ThomasJagielski/MADVLSI-Final_Project/docs/adc.png

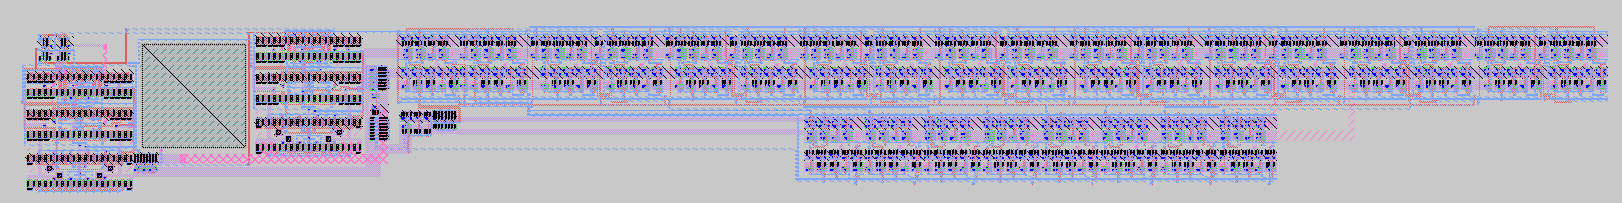
docs/adc.png
