ThomasJagielski/MADVLSI-Final_Project/docs/bandgap_ping_pong.png

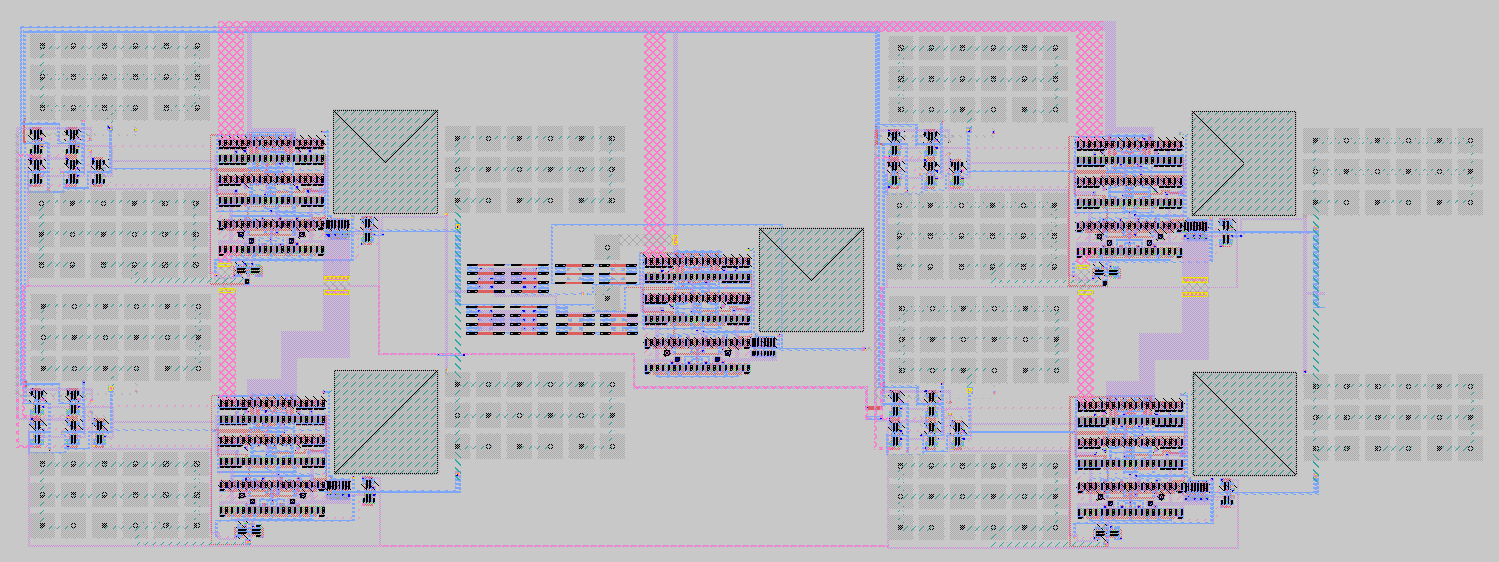
docs/bandgap_ping_pong.png
