ThomasJagielski/MADVLSI-Final_Project/docs/cap8to1.png

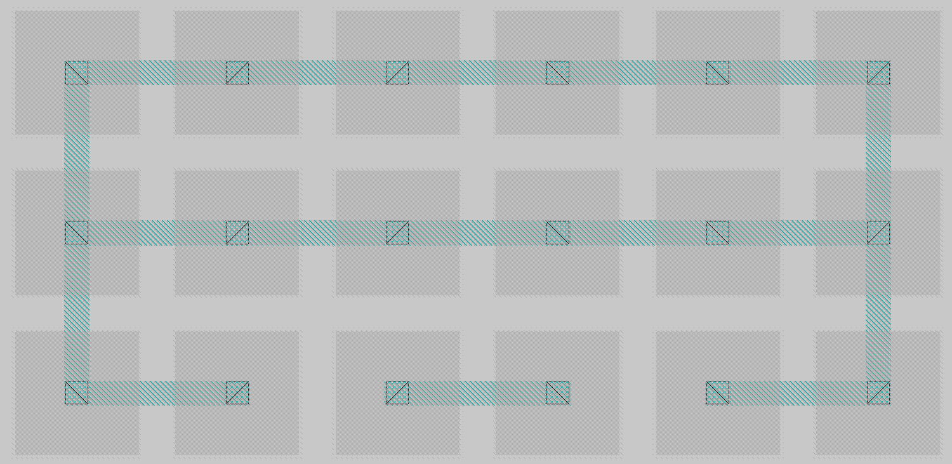
docs/cap8to1.png
