ThomasJagielski/MADVLSI-Final_Project/docs/comparator.png

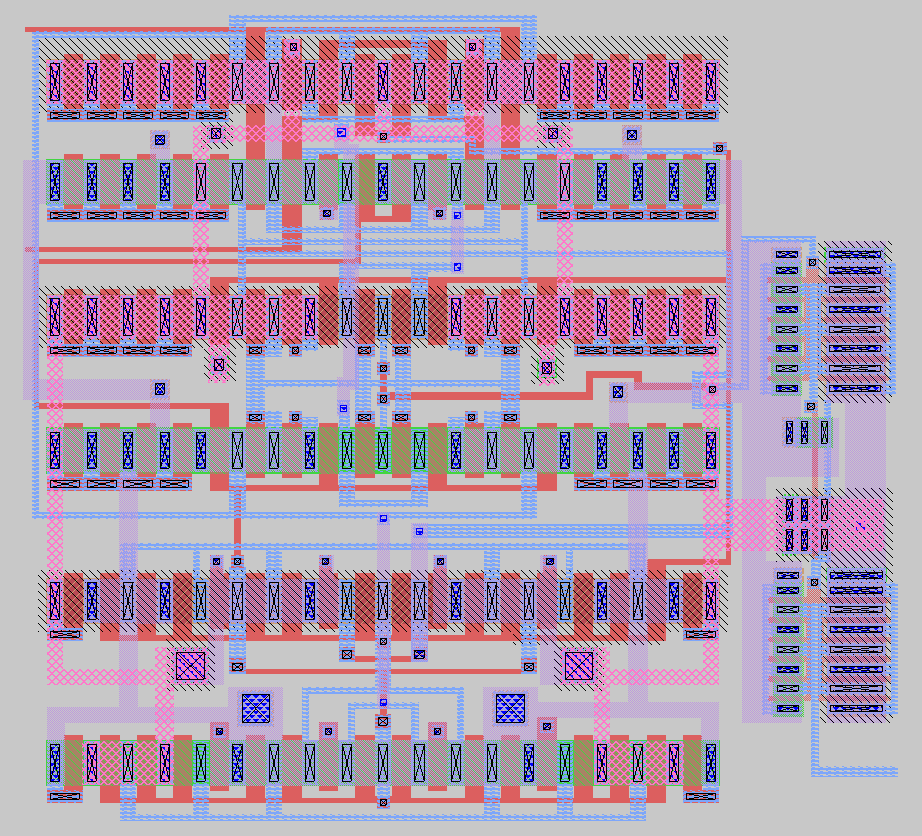
docs/comparator.png
