ThomasJagielski/MADVLSI-Final_Project/docs/middle_ping_pong_amplifier.png

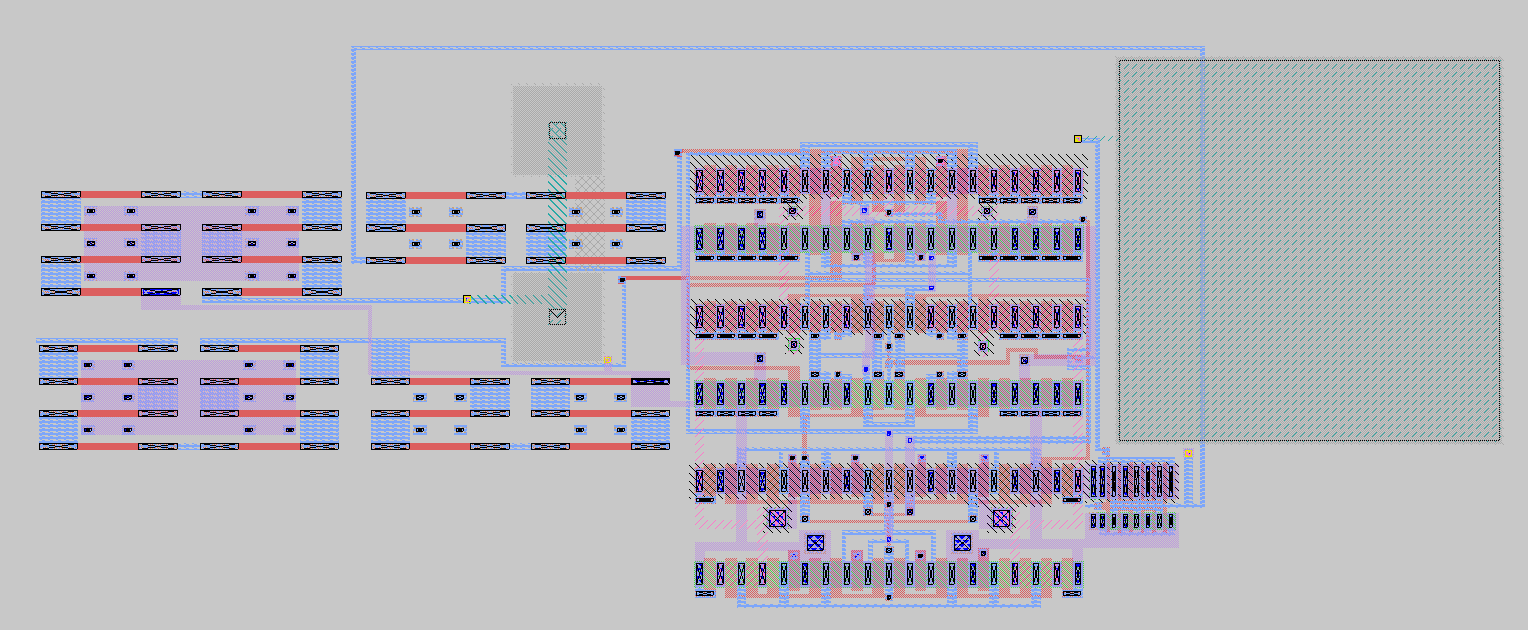
docs/middle_ping_pong_amplifier.png
