ThomasJagielski/MADVLSI-Final_Project/docs/output_register.png

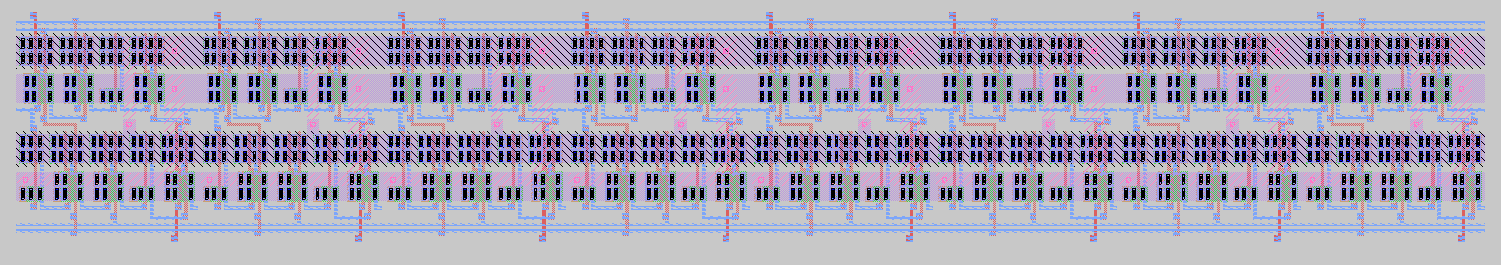
docs/output_register.png
