ThomasJagielski/MADVLSI-Final_Project/synthesized/counter/magic/counter.gds.png

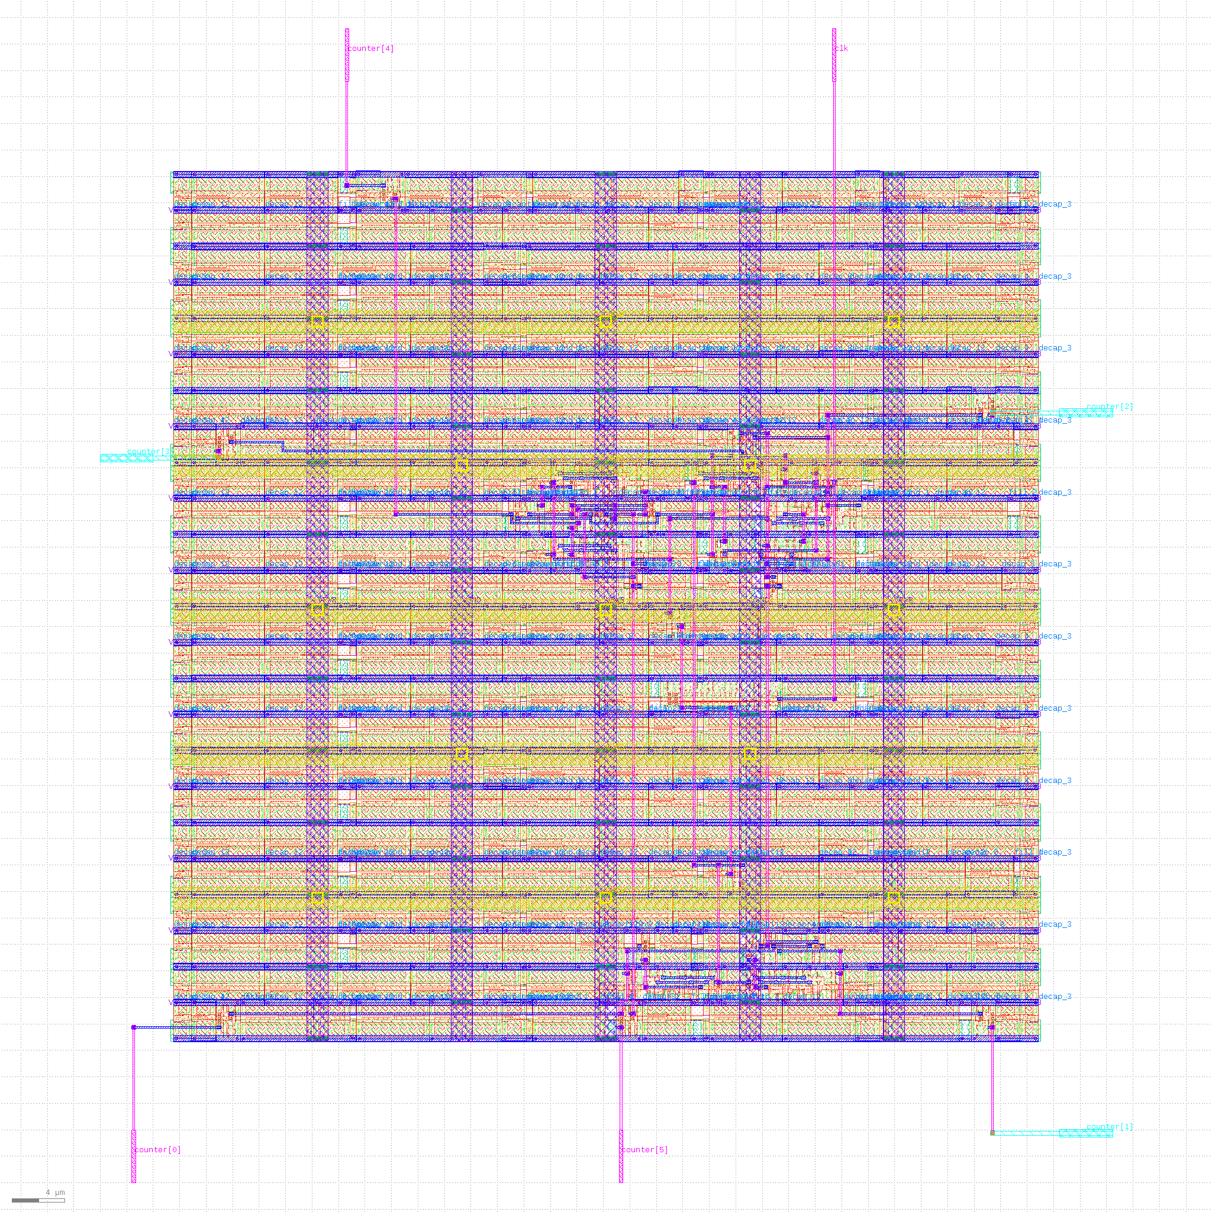
synthesized/counter/magic/counter.gds.png
