ThomasJagielski/MADVLSI-Final_Project/schematic/data/Vtemp_test-20-100Cndiode.csv

 vbep            v(Vbep)         vbep            v(vben)         yes             currtemp
 9.74964207e-01  9.74964207e-01  9.74964207e-01  9.24703032e-01  1.00000000e+00 -2.00000000e+01
 9.74206963e-01  9.74206963e-01  9.74206963e-01  9.23756736e-01  1.00000000e+00 -1.90000000e+01
 9.73447955e-01  9.73447955e-01  9.73447955e-01  9.22808677e-01  1.00000000e+00 -1.80000000e+01
 9.72687192e-01  9.72687192e-01  9.72687192e-01  9.21858862e-01  1.00000000e+00 -1.70000000e+01
 9.71924679e-01  9.71924679e-01  9.71924679e-01  9.20907299e-01  1.00000000e+00 -1.60000000e+01
 9.71160423e-01  9.71160423e-01  9.71160423e-01  9.19953993e-01  1.00000000e+00 -1.50000000e+01
 9.70394432e-01  9.70394432e-01  9.70394432e-01  9.18998952e-01  1.00000000e+00 -1.40000000e+01
 9.69626712e-01  9.69626712e-01  9.69626712e-01  9.18042182e-01  1.00000000e+00 -1.30000000e+01
 9.68857269e-01  9.68857269e-01  9.68857269e-01  9.17083690e-01  1.00000000e+00 -1.20000000e+01
 9.68086110e-01  9.68086110e-01  9.68086110e-01  9.16123482e-01  1.00000000e+00 -1.10000000e+01
 9.67313242e-01  9.67313242e-01  9.67313242e-01  9.15161566e-01  1.00000000e+00 -1.00000000e+01
 9.66538671e-01  9.66538671e-01  9.66538671e-01  9.14197947e-01  1.00000000e+00 -9.00000000e+00
 9.65762404e-01  9.65762404e-01  9.65762404e-01  9.13232633e-01  1.00000000e+00 -8.00000000e+00
 9.64984446e-01  9.64984446e-01  9.64984446e-01  9.12265628e-01  1.00000000e+00 -7.00000000e+00
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
 8.74954367e-01  8.74954367e-01  8.74954367e-01  8.02383361e-01  1.00000000e+00  9.80000000e+01
 8.74025949e-01  8.74025949e-01  8.74025949e-01  8.01265880e-01  1.00000000e+00  9.90000000e+01
 8.73096327e-01  8.73096327e-01  8.73096327e-01  8.00147194e-01  1.00000000e+00  1.00000000e+02
