ThomasJagielski/MADVLSI-Final_Project/synthesized/decimation_filter/results/cts/decimation_filter.cts.def.png

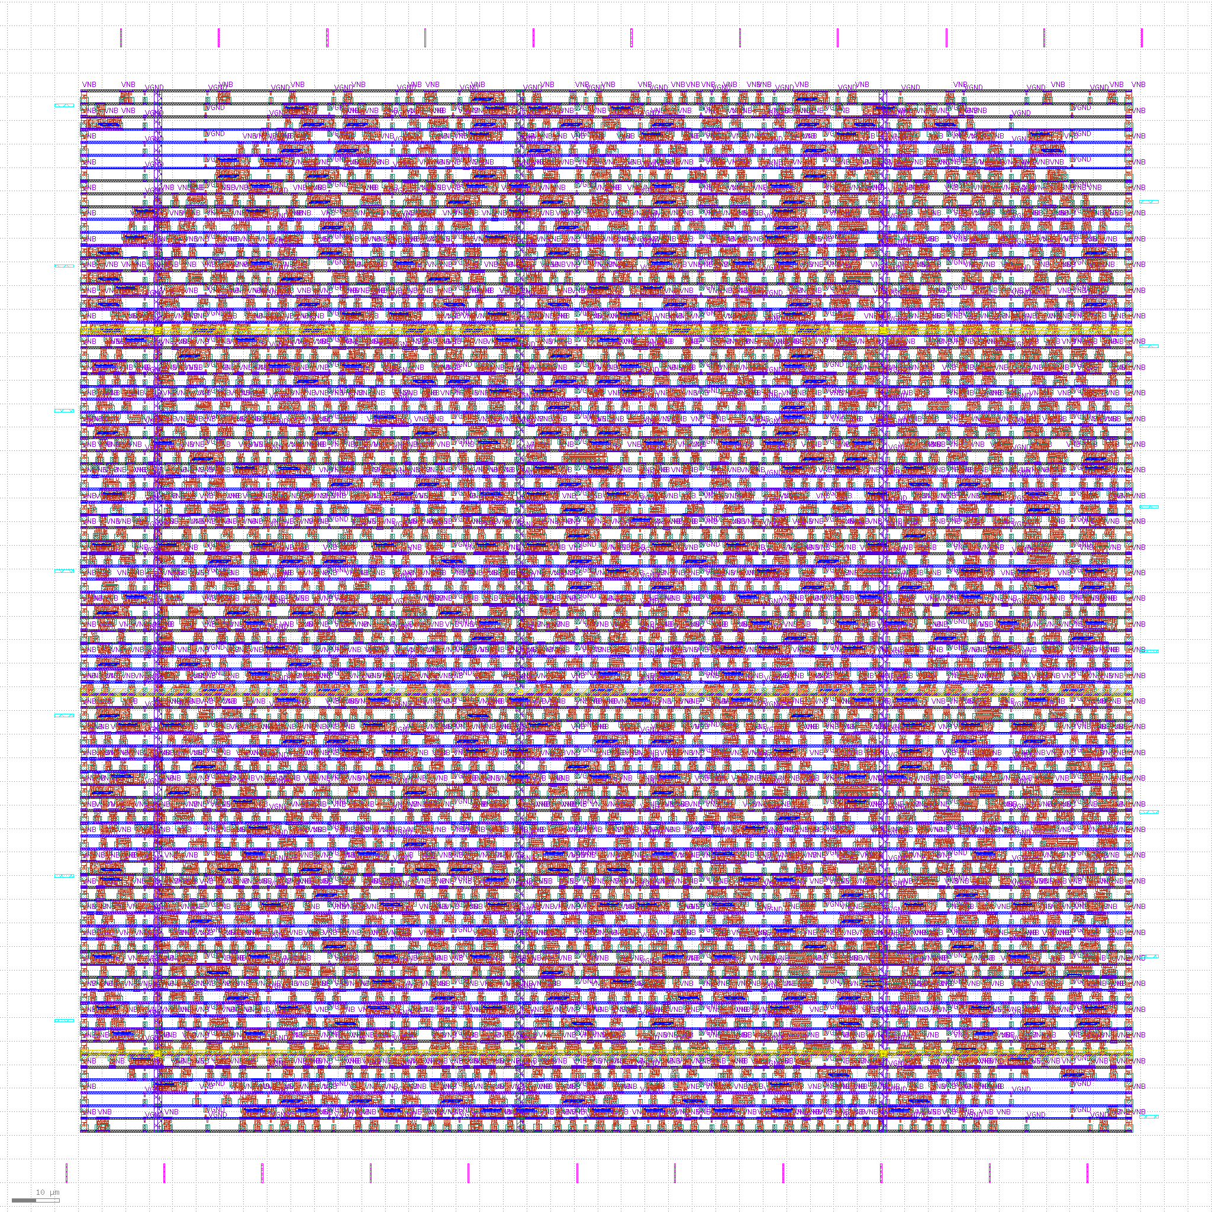
synthesized/decimation_filter/results/cts/decimation_filter.cts.def.png
