ThomasJagielski/MADVLSI-Final_Project/synthesized/decimation_filter/results/floorplan/decimation_filter.floorplan.def.png

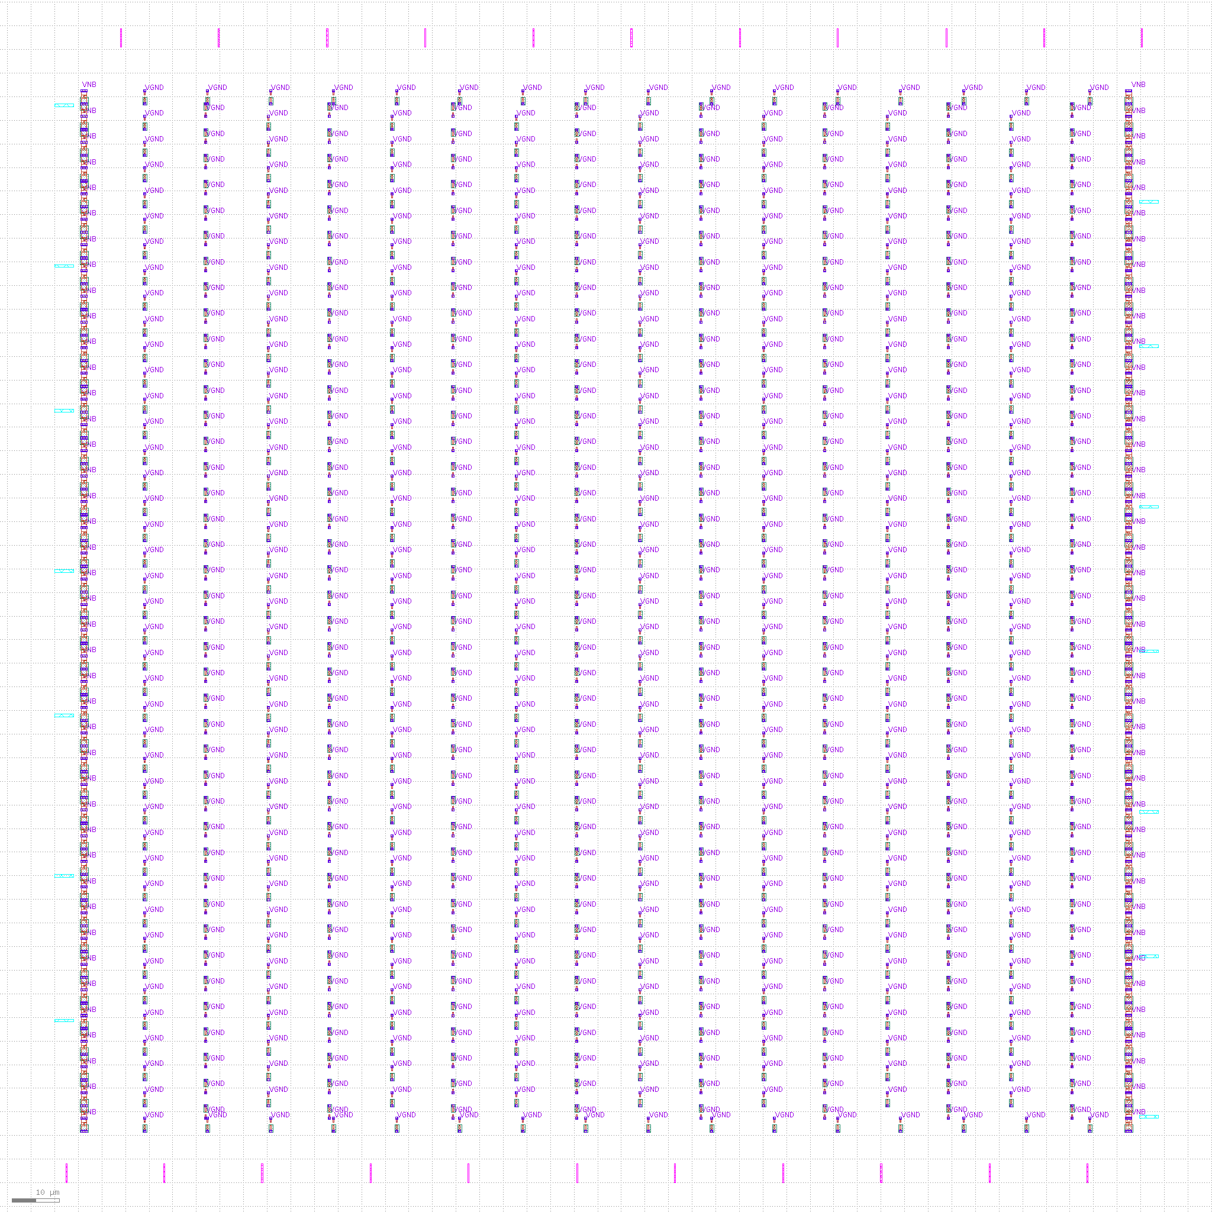
synthesized/decimation_filter/results/floorplan/decimation_filter.floorplan.def.png
