ThomasJagielski/MADVLSI-Final_Project/synthesized/decimation_filter/results/magic/decimation_filter.gds.png

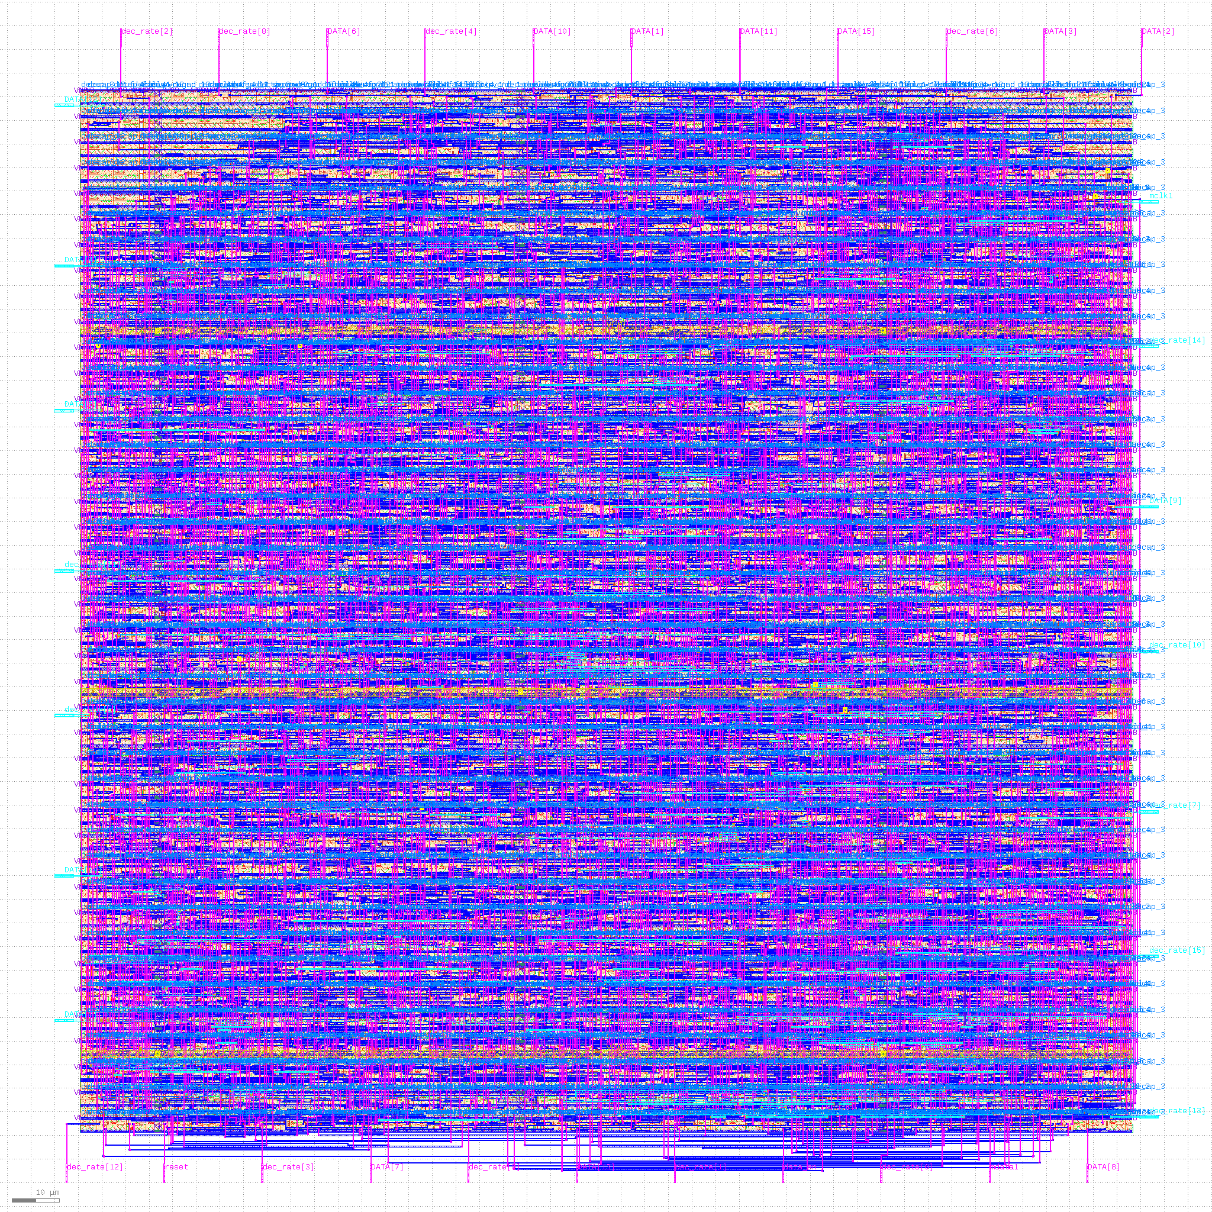
synthesized/decimation_filter/results/magic/decimation_filter.gds.png
