ThomasJagielski/MADVLSI-Final_Project/synthesized/decimation_filter/results/routing/decimation_filter.def.png

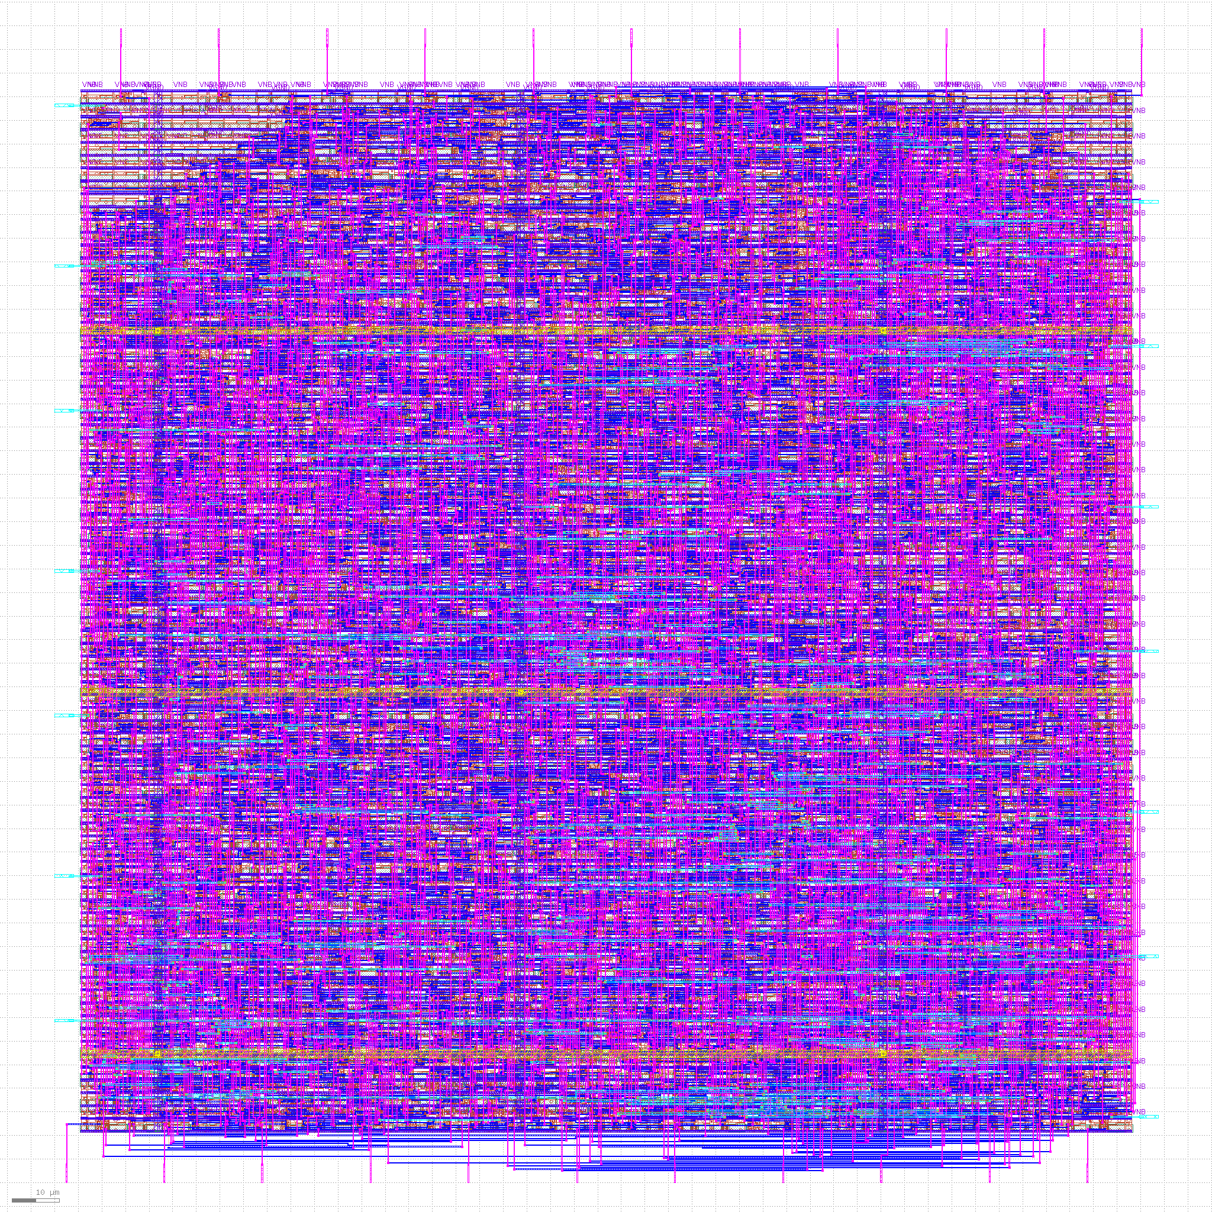
synthesized/decimation_filter/results/routing/decimation_filter.def.png
