ThomasJagielski/MADVLSI-Final_Project/lvs/temperature_sensor/test/temp_sense_test_lvs.spice

**.subckt temp_sense_test_lvs
X38 VDD Vflag GND net15 adc_CLK and2
X39 Q0 __UNCONNECTED_PIN__0 Qout0 Vflag P C dff
X40 Q1 __UNCONNECTED_PIN__1 Qout1 Vflag P C dff
X47 Q2 __UNCONNECTED_PIN__2 Qout2 Vflag P C dff
X48 Q3 __UNCONNECTED_PIN__3 Qout3 Vflag P C dff
X49 Q4 __UNCONNECTED_PIN__4 Qout4 Vflag P C dff
X50 Q5 __UNCONNECTED_PIN__5 Qout5 Vflag P C dff
X51 Q6 __UNCONNECTED_PIN__6 Qout6 Vflag P C dff
X52 Q7 __UNCONNECTED_PIN__7 Qout7 Vflag P C dff
X43 Qn0 __UNCONNECTED_PIN__8 net4 net3 P C dff
X44 net4 Qn0 __UNCONNECTED_PIN__9 net5 C P dff
X45 net3 net5 VDD GND inverter
X46 Qn1 __UNCONNECTED_PIN__10 net6 net17 P C dff
X53 net6 Qn1 __UNCONNECTED_PIN__11 Q0 C P dff
X54 Q0 net17 VDD GND inverter
X55 Qn2 __UNCONNECTED_PIN__12 net7 net18 P C dff
X56 net7 Qn2 __UNCONNECTED_PIN__13 Q1 C P dff
X57 Qn3 __UNCONNECTED_PIN__14 net8 net19 P C dff
X58 net8 Qn3 __UNCONNECTED_PIN__15 Q2 C P dff
X61 Q1 net18 VDD GND inverter
X62 Q2 net19 VDD GND inverter
X64 net4 Q0 VDD GND inverter
X65 net6 Q1 VDD GND inverter
X66 net7 Q2 VDD GND inverter
X67 net8 Q3 VDD GND inverter
X41 Qn4 __UNCONNECTED_PIN__16 net9 net20 P C dff
X42 net9 Qn4 __UNCONNECTED_PIN__17 Q3 C P dff
X59 Q3 net20 VDD GND inverter
X60 net9 Q4 VDD GND inverter
X63 Qn5 __UNCONNECTED_PIN__18 net10 net21 P C dff
X68 net10 Qn5 __UNCONNECTED_PIN__19 Q4 C P dff
X69 Q4 net21 VDD GND inverter
X70 Qn6 __UNCONNECTED_PIN__20 net11 net22 P C dff
X71 net11 Qn6 __UNCONNECTED_PIN__21 Q5 C P dff
X72 Qn7 __UNCONNECTED_PIN__22 net12 net23 P C dff
X73 net12 Qn7 __UNCONNECTED_PIN__23 Q6 C P dff
X74 Q5 net22 VDD GND inverter
X75 Q6 net23 VDD GND inverter
X76 net10 Q5 VDD GND inverter
X77 net11 Q6 VDD GND inverter
X78 net12 Q7 VDD GND inverter
X79 Qn8 __UNCONNECTED_PIN__24 net13 net24 P C dff
X80 net13 Qn8 __UNCONNECTED_PIN__25 Q7 C P dff
X81 Q7 net24 VDD GND inverter
X82 net13 Q8 VDD GND inverter
X83 net1 net2 NP P switch Wp=1 Lp=0.15 WW=1 LL=0.15
X84 Vref_adc net1 NP P switch Wp=1 Lp=0.15 WW=1 LL=0.15
X85 Vref_adc net2 net1 selfbiasedcascode2stage_lvs
X86 Vref_adc net1 Vflag comparator_lvs
XM25 net14 net15 VDD VDD sky130_fd_pr__pfet_01v8 L=0.15 W=2 nf=1 ad='int((nf+1)/2) * W/nf * 0.29' as='int((nf+2)/2) * W/nf * 0.29'
+ pd='2*int((nf+1)/2) * (W/nf + 0.29)' ps='2*int((nf+2)/2) * (W/nf + 0.29)' nrd='0.29 / W' nrs='0.29 / W'
+ sa=0 sb=0 sd=0 mult=1 m=1 
XM26 net14 net15 GND GND sky130_fd_pr__nfet_01v8 L=0.15 W=1 nf=1 ad='int((nf+1)/2) * W/nf * 0.29' as='int((nf+2)/2) * W/nf * 0.29'
+ pd='2*int((nf+1)/2) * (W/nf + 0.29)' ps='2*int((nf+2)/2) * (W/nf + 0.29)' nrd='0.29 / W' nrs='0.29 / W'
+ sa=0 sb=0 sd=0 mult=1 m=1 
XM27 net3 net14 VDD VDD sky130_fd_pr__pfet_01v8 L=0.15 W=12 nf=1 ad='int((nf+1)/2) * W/nf * 0.29' as='int((nf+2)/2) * W/nf * 0.29'
+ pd='2*int((nf+1)/2) * (W/nf + 0.29)' ps='2*int((nf+2)/2) * (W/nf + 0.29)' nrd='0.29 / W' nrs='0.29 / W'
+ sa=0 sb=0 sd=0 mult=1 m=1 
XM28 net3 net14 GND GND sky130_fd_pr__nfet_01v8 L=0.15 W=6 nf=1 ad='int((nf+1)/2) * W/nf * 0.29' as='int((nf+2)/2) * W/nf * 0.29'
+ pd='2*int((nf+1)/2) * (W/nf + 0.29)' ps='2*int((nf+2)/2) * (W/nf + 0.29)' nrd='0.29 / W' nrs='0.29 / W'
+ sa=0 sb=0 sd=0 mult=1 m=1 
X87 __UNCONNECTED_PIN__26 net16 GND Q8 mux2
**.ends

* expanding   symbol:  /home/madvlsi/Documents/MADVLSI-Final_Project/schematic/and2.sym # of pins=5

.subckt and2  VP A VN Y B
*.iopin VP
*.iopin VN
*.ipin A
*.ipin B
*.opin Y
X1 A B net1 VP VN nand2
X2 net1 Y VP VN inverter
.ends


* expanding   symbol:  /home/madvlsi/Documents/MADVLSI-Final_Project/schematic/dff.sym # of pins=6

.subckt dff  D Qn Q CLK Preset Clear
*.ipin D
*.iopin CLK
*.opin Qn
*.opin Q
*.ipin Preset
*.ipin Clear
X6 D CLK net4 VDD GND nand2
X7 net1 CLK net2 VDD GND nand2
X8 Q net3 Qn VDD GND nand2
X9 net5 Qn Q VDD GND nand2
X10 D net1 VDD GND inverter
X1 VDD Preset GND net5 net4 and2
X2 VDD net2 GND net3 Clear and2
.ends


* expanding   symbol:  /home/madvlsi/Documents/MADVLSI-Final_Project/schematic/inverter.sym # of
*+ pins=4

.subckt inverter  A Y VP VN
*.ipin A
*.iopin VP
*.iopin VN
*.opin Y
XM1 Y A VP VP sky130_fd_pr__pfet_01v8 L=0.15 W=2 nf=1 ad='int((nf+1)/2) * W/nf * 0.29' as='int((nf+2)/2) * W/nf * 0.29'
+ pd='2*int((nf+1)/2) * (W/nf + 0.29)' ps='2*int((nf+2)/2) * (W/nf + 0.29)' nrd='0.29 / W' nrs='0.29 / W'
+ sa=0 sb=0 sd=0 mult=1 m=1 
XM2 Y A VN VN sky130_fd_pr__nfet_01v8 L=0.15 W=1 nf=1 ad='int((nf+1)/2) * W/nf * 0.29' as='int((nf+2)/2) * W/nf * 0.29'
+ pd='2*int((nf+1)/2) * (W/nf + 0.29)' ps='2*int((nf+2)/2) * (W/nf + 0.29)' nrd='0.29 / W' nrs='0.29 / W'
+ sa=0 sb=0 sd=0 mult=1 m=1 
.ends


* expanding   symbol:  /home/madvlsi/Documents/MADVLSI-Final_Project/schematic/switch.sym # of
*+ pins=4

.subckt switch  B A CLK nCLK   Wp=1 Lp=0.15 WW=1 LL=0.15
*.iopin B
*.iopin A
*.ipin CLK
*.ipin nCLK
*.ipin CLK
*.ipin CLK
*.ipin nCLK
*.ipin nCLK
XM1 A CLK B GND sky130_fd_pr__nfet_01v8 L='LL' W='WW' nf=1 ad='int((nf+1)/2) * W/nf * 0.29' as='int((nf+2)/2) * W/nf * 0.29'
+ pd='2*int((nf+1)/2) * (W/nf + 0.29)' ps='2*int((nf+2)/2) * (W/nf + 0.29)' nrd='0.29 / W' nrs='0.29 / W'
+ sa=0 sb=0 sd=0 mult=1 m=1 
XM2 A nCLK B VDD sky130_fd_pr__pfet_01v8 L='Lp' W='Wp' nf=1 ad='int((nf+1)/2) * W/nf * 0.29' as='int((nf+2)/2) * W/nf * 0.29'
+ pd='2*int((nf+1)/2) * (W/nf + 0.29)' ps='2*int((nf+2)/2) * (W/nf + 0.29)' nrd='0.29 / W' nrs='0.29 / W'
+ sa=0 sb=0 sd=0 mult=1 m=1 
XM3 B CLK B VDD sky130_fd_pr__pfet_01v8 L='Lp' W='Wp/2' nf=1 ad='int((nf+1)/2) * W/nf * 0.29' as='int((nf+2)/2) * W/nf * 0.29'
+ pd='2*int((nf+1)/2) * (W/nf + 0.29)' ps='2*int((nf+2)/2) * (W/nf + 0.29)' nrd='0.29 / W' nrs='0.29 / W'
+ sa=0 sb=0 sd=0 mult=1 m=1 
XM4 A CLK A VDD sky130_fd_pr__pfet_01v8 L='Lp' W='Wp/2' nf=1 ad='int((nf+1)/2) * W/nf * 0.29' as='int((nf+2)/2) * W/nf * 0.29'
+ pd='2*int((nf+1)/2) * (W/nf + 0.29)' ps='2*int((nf+2)/2) * (W/nf + 0.29)' nrd='0.29 / W' nrs='0.29 / W'
+ sa=0 sb=0 sd=0 mult=1 m=1 
XM5 B nCLK B GND sky130_fd_pr__nfet_01v8 L='LL' W='WW/2' nf=1 ad='int((nf+1)/2) * W/nf * 0.29' as='int((nf+2)/2) * W/nf * 0.29'
+ pd='2*int((nf+1)/2) * (W/nf + 0.29)' ps='2*int((nf+2)/2) * (W/nf + 0.29)' nrd='0.29 / W' nrs='0.29 / W'
+ sa=0 sb=0 sd=0 mult=1 m=1 
XM6 A nCLK A GND sky130_fd_pr__nfet_01v8 L='LL' W='WW/2' nf=1 ad='int((nf+1)/2) * W/nf * 0.29' as='int((nf+2)/2) * W/nf * 0.29'
+ pd='2*int((nf+1)/2) * (W/nf + 0.29)' ps='2*int((nf+2)/2) * (W/nf + 0.29)' nrd='0.29 / W' nrs='0.29 / W'
+ sa=0 sb=0 sd=0 mult=1 m=1 
.ends


* expanding   symbol:
*+  /home/madvlsi/Documents/MADVLSI-Final_Project/schematic/selfbiasedcascode2stage_lvs.sym # of pins=3

.subckt selfbiasedcascode2stage_lvs  vp vm vout
*.ipin vm
*.ipin vp
*.opin vout
XMdummy1 net4 VDD net5 VDD sky130_fd_pr__pfet_01v8 L=0.6 W=1.5 nf=1 ad='int((nf+1)/2) * W/nf * 0.29'
+ as='int((nf+2)/2) * W/nf * 0.29' pd='2*int((nf+1)/2) * (W/nf + 0.29)' ps='2*int((nf+2)/2) * (W/nf + 0.29)'
+ nrd='0.29 / W' nrs='0.29 / W' sa=0 sb=0 sd=0 mult=1 m=1 
XM16a net4 vp net5 VDD sky130_fd_pr__pfet_01v8 L=0.6 W=1.5 nf=1 ad='int((nf+1)/2) * W/nf * 0.29' as='int((nf+2)/2) * W/nf * 0.29'
+ pd='2*int((nf+1)/2) * (W/nf + 0.29)' ps='2*int((nf+2)/2) * (W/nf + 0.29)' nrd='0.29 / W' nrs='0.29 / W'
+ sa=0 sb=0 sd=0 mult=1 m=1 
XM14a VDD net6 net4 VDD sky130_fd_pr__pfet_01v8 L=0.6 W=1.5 nf=1 ad='int((nf+1)/2) * W/nf * 0.29' as='int((nf+2)/2) * W/nf * 0.29'
+ pd='2*int((nf+1)/2) * (W/nf + 0.29)' ps='2*int((nf+2)/2) * (W/nf + 0.29)' nrd='0.29 / W' nrs='0.29 / W'
+ sa=0 sb=0 sd=0 mult=1 m=1 
XM14b net4 net6 VDD VDD sky130_fd_pr__pfet_01v8 L=0.6 W=1.5 nf=1 ad='int((nf+1)/2) * W/nf * 0.29' as='int((nf+2)/2) * W/nf * 0.29'
+ pd='2*int((nf+1)/2) * (W/nf + 0.29)' ps='2*int((nf+2)/2) * (W/nf + 0.29)' nrd='0.29 / W' nrs='0.29 / W'
+ sa=0 sb=0 sd=0 mult=1 m=1 
XM15a net4 vm net8 VDD sky130_fd_pr__pfet_01v8 L=0.6 W=1.5 nf=1 ad='int((nf+1)/2) * W/nf * 0.29' as='int((nf+2)/2) * W/nf * 0.29'
+ pd='2*int((nf+1)/2) * (W/nf + 0.29)' ps='2*int((nf+2)/2) * (W/nf + 0.29)' nrd='0.29 / W' nrs='0.29 / W'
+ sa=0 sb=0 sd=0 mult=1 m=1 
XM16b net5 vp net4 VDD sky130_fd_pr__pfet_01v8 L=0.6 W=1.5 nf=1 ad='int((nf+1)/2) * W/nf * 0.29' as='int((nf+2)/2) * W/nf * 0.29'
+ pd='2*int((nf+1)/2) * (W/nf + 0.29)' ps='2*int((nf+2)/2) * (W/nf + 0.29)' nrd='0.29 / W' nrs='0.29 / W'
+ sa=0 sb=0 sd=0 mult=1 m=1 
XMdummy3 net1 GND net3 GND sky130_fd_pr__nfet_01v8 L=0.6 W=1.5 nf=1 ad='int((nf+1)/2) * W/nf * 0.29'
+ as='int((nf+2)/2) * W/nf * 0.29' pd='2*int((nf+1)/2) * (W/nf + 0.29)' ps='2*int((nf+2)/2) * (W/nf + 0.29)'
+ nrd='0.29 / W' nrs='0.29 / W' sa=0 sb=0 sd=0 mult=1 m=1 
XM6a net1 net2 GND GND sky130_fd_pr__nfet_01v8 L=0.6 W=1.5 nf=1 ad='int((nf+1)/2) * W/nf * 0.29' as='int((nf+2)/2) * W/nf * 0.29'
+ pd='2*int((nf+1)/2) * (W/nf + 0.29)' ps='2*int((nf+2)/2) * (W/nf + 0.29)' nrd='0.29 / W' nrs='0.29 / W'
+ sa=0 sb=0 sd=0 mult=1 m=1 
XM6b GND net2 net1 GND sky130_fd_pr__nfet_01v8 L=0.6 W=1.5 nf=1 ad='int((nf+1)/2) * W/nf * 0.29' as='int((nf+2)/2) * W/nf * 0.29'
+ pd='2*int((nf+1)/2) * (W/nf + 0.29)' ps='2*int((nf+2)/2) * (W/nf + 0.29)' nrd='0.29 / W' nrs='0.29 / W'
+ sa=0 sb=0 sd=0 mult=1 m=1 
XMdummy4 net3 GND net1 GND sky130_fd_pr__nfet_01v8 L=0.6 W=1.5 nf=1 ad='int((nf+1)/2) * W/nf * 0.29'
+ as='int((nf+2)/2) * W/nf * 0.29' pd='2*int((nf+1)/2) * (W/nf + 0.29)' ps='2*int((nf+2)/2) * (W/nf + 0.29)'
+ nrd='0.29 / W' nrs='0.29 / W' sa=0 sb=0 sd=0 mult=1 m=1 
XM8a net7 vm net1 GND sky130_fd_pr__nfet_01v8 L=0.6 W=1.5 nf=1 ad='int((nf+1)/2) * W/nf * 0.29' as='int((nf+2)/2) * W/nf * 0.29'
+ pd='2*int((nf+1)/2) * (W/nf + 0.29)' ps='2*int((nf+2)/2) * (W/nf + 0.29)' nrd='0.29 / W' nrs='0.29 / W'
+ sa=0 sb=0 sd=0 mult=1 m=1 
XM7a net1 vp net3 GND sky130_fd_pr__nfet_01v8 L=0.6 W=1.5 nf=1 ad='int((nf+1)/2) * W/nf * 0.29' as='int((nf+2)/2) * W/nf * 0.29'
+ pd='2*int((nf+1)/2) * (W/nf + 0.29)' ps='2*int((nf+2)/2) * (W/nf + 0.29)' nrd='0.29 / W' nrs='0.29 / W'
+ sa=0 sb=0 sd=0 mult=1 m=1 
XMdummy2 net5 VDD net4 VDD sky130_fd_pr__pfet_01v8 L=0.6 W=1.5 nf=1 ad='int((nf+1)/2) * W/nf * 0.29'
+ as='int((nf+2)/2) * W/nf * 0.29' pd='2*int((nf+1)/2) * (W/nf + 0.29)' ps='2*int((nf+2)/2) * (W/nf + 0.29)'
+ nrd='0.29 / W' nrs='0.29 / W' sa=0 sb=0 sd=0 mult=1 m=1 
XM15b net8 vm net4 VDD sky130_fd_pr__pfet_01v8 L=0.6 W=1.5 nf=1 ad='int((nf+1)/2) * W/nf * 0.29' as='int((nf+2)/2) * W/nf * 0.29'
+ pd='2*int((nf+1)/2) * (W/nf + 0.29)' ps='2*int((nf+2)/2) * (W/nf + 0.29)' nrd='0.29 / W' nrs='0.29 / W'
+ sa=0 sb=0 sd=0 mult=1 m=1 
XM7b net3 vp net1 GND sky130_fd_pr__nfet_01v8 L=0.6 W=1.5 nf=1 ad='int((nf+1)/2) * W/nf * 0.29' as='int((nf+2)/2) * W/nf * 0.29'
+ pd='2*int((nf+1)/2) * (W/nf + 0.29)' ps='2*int((nf+2)/2) * (W/nf + 0.29)' nrd='0.29 / W' nrs='0.29 / W'
+ sa=0 sb=0 sd=0 mult=1 m=1 
XM8b net1 vm net7 GND sky130_fd_pr__nfet_01v8 L=0.6 W=1.5 nf=1 ad='int((nf+1)/2) * W/nf * 0.29' as='int((nf+2)/2) * W/nf * 0.29'
+ pd='2*int((nf+1)/2) * (W/nf + 0.29)' ps='2*int((nf+2)/2) * (W/nf + 0.29)' nrd='0.29 / W' nrs='0.29 / W'
+ sa=0 sb=0 sd=0 mult=1 m=1 
XM10a net7 net6 VDD VDD sky130_fd_pr__pfet_01v8 L=0.6 W=1.5 nf=1 ad='int((nf+1)/2) * W/nf * 0.29' as='int((nf+2)/2) * W/nf * 0.29'
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
+ sa=0 sb=0 sd=0 mult=1 m=1 
XM10 VDD VDD net8 VDD sky130_fd_pr__pfet_01v8 L=0.6 W=1.5 nf=1 ad='int((nf+1)/2) * W/nf * 0.29' as='int((nf+2)/2) * W/nf * 0.29'
+ pd='2*int((nf+1)/2) * (W/nf + 0.29)' ps='2*int((nf+2)/2) * (W/nf + 0.29)' nrd='0.29 / W' nrs='0.29 / W'
+ sa=0 sb=0 sd=0 mult=1 m=1
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
