ThomasJagielski/MADVLSI-Final_Project/layout/bandgap_ping_pong_thomas.spice

* SPICE3 file created from bandgap_ping_pong_thomas.ext - technology: sky130A

.option scale=5000u

X0 middle_ping_pong_amplifier_0/m3cap50f_1/1 VSUBS sky130_fd_pr__cap_mim_m3_1 l=1000 w=1000
X1 middle_ping_pong_amplifier_0/m3cap50f_1/1 VSUBS sky130_fd_pr__cap_mim_m3_1 l=1000 w=1000
X2 middle_ping_pong_amplifier_0/p-res8x20k_0/2 middle_ping_pong_amplifier_0/p-res8x20k_0/p-res20k_1/2 VSUBS sky130_fd_pr__res_xhigh_po w=70 l=700
X3 middle_ping_pong_amplifier_0/p-res8x20k_0/p-res20k_1/2 middle_ping_pong_amplifier_0/p-res8x20k_0/p-res20k_2/2 VSUBS sky130_fd_pr__res_xhigh_po w=70 l=700
X4 middle_ping_pong_amplifier_0/p-res8x20k_0/p-res20k_2/2 middle_ping_pong_amplifier_0/p-res8x20k_0/p-res20k_3/1 VSUBS sky130_fd_pr__res_xhigh_po w=70 l=700
X5 middle_ping_pong_amplifier_0/p-res8x20k_0/p-res20k_4/1 middle_ping_pong_amplifier_0/p-res8x20k_0/p-res20k_3/1 VSUBS sky130_fd_pr__res_xhigh_po w=70 l=700
X6 middle_ping_pong_amplifier_0/p-res8x20k_0/p-res20k_5/2 middle_ping_pong_amplifier_0/p-res8x20k_0/p-res20k_4/1 VSUBS sky130_fd_pr__res_xhigh_po w=70 l=700
X7 middle_ping_pong_amplifier_0/p-res8x20k_0/p-res20k_5/2 middle_ping_pong_amplifier_0/p-res8x20k_0/p-res20k_6/1 VSUBS sky130_fd_pr__res_xhigh_po w=70 l=700
X8 middle_ping_pong_amplifier_0/p-res8x20k_0/p-res20k_7/1 middle_ping_pong_amplifier_0/p-res8x20k_0/p-res20k_6/1 VSUBS sky130_fd_pr__res_xhigh_po w=70 l=700
X9 cap8to1_1/m3cap50f_9/1 middle_ping_pong_amplifier_0/p-res8x20k_0/p-res20k_7/1 VSUBS sky130_fd_pr__res_xhigh_po w=70 l=700
X10 middle_ping_pong_amplifier_0/selfbiasedcascode2stage_0/m3cap500f_0/1 middle_ping_pong_amplifier_0/selfbiasedcascode2stage_0/Vout sky130_fd_pr__cap_mim_m3_1 l=4400 w=4400
X11 middle_ping_pong_amplifier_0/selfbiasedcascode2stage_0/a_840_7800# middle_ping_pong_amplifier_0/selfbiasedcascode2stage_0/a_0_5820# VDD VDD sky130_fd_pr__pfet_01v8 ad=0 pd=0 as=-1 ps=-1 w=300 l=120
X12 VDD middle_ping_pong_amplifier_0/selfbiasedcascode2stage_0/a_n440_7350# middle_ping_pong_amplifier_0/selfbiasedcascode2stage_0/a_120_4860# VSUBS sky130_fd_pr__nfet_01v8 ad=-0 pd=-0 as=-1 ps=-1 w=300 l=120
X13 middle_ping_pong_amplifier_0/selfbiasedcascode2stage_0/a_840_6920# VSUBS middle_ping_pong_amplifier_0/selfbiasedcascode2stage_0/a_0_5820# VSUBS sky130_fd_pr__nfet_01v8 ad=8.38861e+06 pd=0 as=5.36871e+08 ps=0 w=300 l=120
X14 VSUBS middle_ping_pong_amplifier_0/selfbiasedcascode2stage_0/a_n440_7350# middle_ping_pong_amplifier_0/selfbiasedcascode2stage_0/a_1320_9350# VSUBS sky130_fd_pr__nfet_01v8 ad=-1.05024e+09 pd=21919 as=0 ps=0 w=300 l=120
X15 VDD middle_ping_pong_amplifier_0/selfbiasedcascode2stage_0/a_0_5820# middle_ping_pong_amplifier_0/selfbiasedcascode2stage_0/a_1320_8690# VDD sky130_fd_pr__pfet_01v8 ad=-0 pd=-0 as=0 ps=0 w=300 l=120
X16 VSUBS VSUBS middle_ping_pong_amplifier_0/selfbiasedcascode2stage_0/a_840_7800# VSUBS sky130_fd_pr__nfet_01v8 ad=-0 pd=0 as=0 ps=0 w=300 l=120
X17 VSUBS VSUBS VSUBS VSUBS sky130_fd_pr__nfet_01v8 ad=-0 pd=0 as=-0 ps=0 w=300 l=120
X18 middle_ping_pong_amplifier_0/selfbiasedcascode2stage_0/a_120_5930# VDD middle_ping_pong_amplifier_0/selfbiasedcascode2stage_0/a_n440_7350# VDD sky130_fd_pr__pfet_01v8 ad=-1.09256e+09 pd=21919 as=-1.06388e+09 ps=21919 w=300 l=120
X19 VDD VDD VDD VDD sky130_fd_pr__pfet_01v8 ad=-0 pd=-0 as=-0 ps=-0 w=300 l=120
X20 middle_ping_pong_amplifier_0/selfbiasedcascode2stage_0/a_1080_8690# middle_ping_pong_amplifier_0/m3cap50f_1/1 middle_ping_pong_amplifier_0/selfbiasedcascode2stage_0/a_840_7800# VSUBS sky130_fd_pr__nfet_01v8 ad=0 pd=0 as=0 ps=0 w=300 l=120
X21 middle_ping_pong_amplifier_0/selfbiasedcascode2stage_0/a_1320_8690# middle_ping_pong_amplifier_0/p-res8x20k_0/2 middle_ping_pong_amplifier_0/selfbiasedcascode2stage_0/a_1080_8690# VSUBS sky130_fd_pr__nfet_01v8 ad=0 pd=0 as=0 ps=0 w=300 l=120
X22 VSUBS VSUBS VSUBS VSUBS sky130_fd_pr__nfet_01v8 ad=-0 pd=0 as=-0 ps=0 w=300 l=120
X23 VSUBS VSUBS VSUBS VSUBS sky130_fd_pr__nfet_01v8 ad=-0 pd=0 as=-0 ps=0 w=300 l=120
X24 VDD middle_ping_pong_amplifier_0/selfbiasedcascode2stage_0/a_n440_7350# middle_ping_pong_amplifier_0/selfbiasedcascode2stage_0/a_120_4860# VSUBS sky130_fd_pr__nfet_01v8 ad=-0 pd=-0 as=-0 ps=-0 w=300 l=120
X25 VDD VDD VDD VDD sky130_fd_pr__pfet_01v8 ad=-0 pd=-0 as=-0 ps=-0 w=300 l=120
X26 middle_ping_pong_amplifier_0/selfbiasedcascode2stage_0/a_120_5930# middle_ping_pong_amplifier_0/selfbiasedcascode2stage_0/a_0_5820# middle_ping_pong_amplifier_0/selfbiasedcascode2stage_0/a_n440_7350# VDD sky130_fd_pr__pfet_01v8 ad=-0 pd=0 as=-0 ps=0 w=300 l=120
X27 middle_ping_pong_amplifier_0/selfbiasedcascode2stage_0/a_1320_9350# middle_ping_pong_amplifier_0/selfbiasedcascode2stage_0/a_960_6890# middle_ping_pong_amplifier_0/selfbiasedcascode2stage_0/m3cap500f_0/1 VSUBS sky130_fd_pr__nfet_01v8 ad=0 pd=0 as=-1.10259e+09 ps=21919 w=300 l=120
X28 VDD middle_ping_pong_amplifier_0/selfbiasedcascode2stage_0/a_0_5820# middle_ping_pong_amplifier_0/selfbiasedcascode2stage_0/a_120_5930# VDD sky130_fd_pr__pfet_01v8 ad=-0 pd=-0 as=-0 ps=0 w=300 l=120
X29 middle_ping_pong_amplifier_0/selfbiasedcascode2stage_0/a_1320_8690# middle_ping_pong_amplifier_0/selfbiasedcascode2stage_0/a_960_6890# middle_ping_pong_amplifier_0/selfbiasedcascode2stage_0/m3cap500f_0/1 VDD sky130_fd_pr__pfet_01v8 ad=0 pd=0 as=-0 ps=0 w=300 l=120
X30 middle_ping_pong_amplifier_0/selfbiasedcascode2stage_0/a_120_5930# middle_ping_pong_amplifier_0/selfbiasedcascode2stage_0/a_0_5820# VSUBS VDD sky130_fd_pr__pfet_01v8 ad=-0 pd=0 as=-0 ps=0 w=300 l=120
X31 VSUBS VSUBS VSUBS VSUBS sky130_fd_pr__nfet_01v8 ad=-0 pd=0 as=-0 ps=0 w=300 l=120
X32 VDD VDD middle_ping_pong_amplifier_0/selfbiasedcascode2stage_0/a_840_6920# VDD sky130_fd_pr__pfet_01v8 ad=-0 pd=-0 as=0 ps=0 w=300 l=120
X33 middle_ping_pong_amplifier_0/selfbiasedcascode2stage_0/a_120_5930# middle_ping_pong_amplifier_0/selfbiasedcascode2stage_0/a_0_5820# VSUBS VDD sky130_fd_pr__pfet_01v8 ad=-0 pd=0 as=-0 ps=0 w=300 l=120
X34 VSUBS VSUBS VSUBS VSUBS sky130_fd_pr__nfet_01v8 ad=-0 pd=0 as=-0 ps=0 w=300 l=120
X35 middle_ping_pong_amplifier_0/selfbiasedcascode2stage_0/a_1320_9350# middle_ping_pong_amplifier_0/selfbiasedcascode2stage_0/a_n440_7350# VSUBS VSUBS sky130_fd_pr__nfet_01v8 ad=0 pd=0 as=-0 ps=0 w=300 l=120
X36 VDD VDD VDD VDD sky130_fd_pr__pfet_01v8 ad=-0 pd=-0 as=-0 ps=-0 w=300 l=120
X37 middle_ping_pong_amplifier_0/selfbiasedcascode2stage_0/a_1320_8690# middle_ping_pong_amplifier_0/selfbiasedcascode2stage_0/a_0_5820# VDD VDD sky130_fd_pr__pfet_01v8 ad=0 pd=0 as=-0 ps=-0 w=300 l=120
X38 middle_ping_pong_amplifier_0/selfbiasedcascode2stage_0/a_1080_9350# middle_ping_pong_amplifier_0/m3cap50f_1/1 middle_ping_pong_amplifier_0/selfbiasedcascode2stage_0/a_840_6920# VDD sky130_fd_pr__pfet_01v8 ad=0 pd=0 as=0 ps=0 w=300 l=120
X39 middle_ping_pong_amplifier_0/selfbiasedcascode2stage_0/a_1320_9350# VDD middle_ping_pong_amplifier_0/selfbiasedcascode2stage_0/a_1080_9350# VDD sky130_fd_pr__pfet_01v8 ad=0 pd=0 as=0 ps=0 w=300 l=120
X40 VDD VDD VDD VDD sky130_fd_pr__pfet_01v8 ad=-0 pd=-0 as=-0 ps=-0 w=300 l=120
X41 middle_ping_pong_amplifier_0/selfbiasedcascode2stage_0/a_120_4860# middle_ping_pong_amplifier_0/selfbiasedcascode2stage_0/a_n440_7350# middle_ping_pong_amplifier_0/selfbiasedcascode2stage_0/a_0_5820# VSUBS sky130_fd_pr__nfet_01v8 ad=-0 pd=-0 as=0 ps=0 w=300 l=120
X42 VSUBS VSUBS VSUBS VSUBS sky130_fd_pr__nfet_01v8 ad=-0 pd=0 as=-0 ps=0 w=300 l=120
X43 VSUBS VSUBS VSUBS VSUBS sky130_fd_pr__nfet_01v8 ad=-0 pd=0 as=-0 ps=0 w=300 l=120
X44 VDD VDD VDD VDD sky130_fd_pr__pfet_01v8 ad=-0 pd=-0 as=-0 ps=-0 w=300 l=120
X45 VDD VDD VDD VDD sky130_fd_pr__pfet_01v8 ad=-0 pd=-0 as=-0 ps=-0 w=300 l=120
X46 VSUBS middle_ping_pong_amplifier_0/selfbiasedcascode2stage_0/a_n440_7350# middle_ping_pong_amplifier_0/selfbiasedcascode2stage_0/a_1080_8690# VSUBS sky130_fd_pr__nfet_01v8 ad=-0 pd=0 as=0 ps=0 w=300 l=120
X47 VDD VDD VSUBS VDD sky130_fd_pr__pfet_01v8 ad=-0 pd=-0 as=-0 ps=0 w=300 l=120
X48 middle_ping_pong_amplifier_0/selfbiasedcascode2stage_0/a_0_5820# middle_ping_pong_amplifier_0/selfbiasedcascode2stage_0/a_0_5820# middle_ping_pong_amplifier_0/selfbiasedcascode2stage_0/a_840_7800# VDD sky130_fd_pr__pfet_01v8 ad=0 pd=0 as=0 ps=0 w=300 l=120
X49 VSUBS VSUBS VSUBS VSUBS sky130_fd_pr__nfet_01v8 ad=-0 pd=0 as=-0 ps=0 w=300 l=120
X50 middle_ping_pong_amplifier_0/selfbiasedcascode2stage_0/a_120_5930# middle_ping_pong_amplifier_0/selfbiasedcascode2stage_0/a_0_5820# VSUBS VDD sky130_fd_pr__pfet_01v8 ad=-0 pd=0 as=-0 ps=0 w=300 l=120
X51 VDD VDD VDD VDD sky130_fd_pr__pfet_01v8 ad=-0 pd=-0 as=-0 ps=-0 w=300 l=120
X52 VDD middle_ping_pong_amplifier_0/selfbiasedcascode2stage_0/a_0_5820# middle_ping_pong_amplifier_0/selfbiasedcascode2stage_0/a_1080_9350# VDD sky130_fd_pr__pfet_01v8 ad=-0 pd=-0 as=0 ps=0 w=300 l=120
X53 middle_ping_pong_amplifier_0/selfbiasedcascode2stage_0/a_960_6890# VSUBS VSUBS VSUBS sky130_fd_pr__nfet_01v8 ad=9 pd=0 as=-0 ps=0 w=300 l=120
X54 middle_ping_pong_amplifier_0/selfbiasedcascode2stage_0/a_960_6890# VDD VDD VDD sky130_fd_pr__pfet_01v8 ad=0 pd=0 as=-0 ps=-0 w=300 l=120
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
