ThomasJagielski/MADVLSI-Final_Project/synthesized/decimation_filter/results/synthesis/decimation_filter.synthesis_cts.v

module decimation_filter (data_en,
    mclk1,
    mdata1,
    reset,
    VPWR,
    VGND,
    DATA,
    dec_rate);
 output data_en;
 input mclk1;
 input mdata1;
 input reset;
 input VPWR;
 input VGND;
 output [15:0] DATA;
 input [15:0] dec_rate;

 sky130_fd_sc_hd__or2_1 _2386_ (.A(_1891_),
    .B(_1893_),
    .X(_1894_));
 sky130_fd_sc_hd__or2_1 _2387_ (.A(_1826_),
    .B(_1894_),
    .X(_1895_));
 sky130_fd_sc_hd__a21oi_2 _2388_ (.A1(\acc3[23] ),
    .A2(\acc2[23] ),
    .B1(_1818_),
    .Y(_1896_));
 sky130_fd_sc_hd__inv_2 _2389_ (.A(_1896_),
    .Y(_1897_));
 sky130_fd_sc_hd__o22a_1 _2390_ (.A1(\acc3[22] ),
    .A2(\acc2[22] ),
    .B1(_1540_),
    .B2(_0517_),
    .X(_1898_));
 sky130_fd_sc_hd__or4b_4 _2391_ (.A(_1895_),
    .B(_1897_),
    .C(_1823_),
    .D_N(_1898_),
    .X(_1899_));
 sky130_fd_sc_hd__o22a_2 _2392_ (.A1(_1818_),
    .A2(_1835_),
    .B1(_1889_),
    .B2(_1899_),
    .X(_1900_));
 sky130_fd_sc_hd__a22o_1 _2393_ (.A1(\acc3[28] ),
    .A2(\acc2[28] ),
    .B1(_1667_),
    .B2(_2350_),
    .X(_1901_));
 sky130_fd_sc_hd__o21ai_1 _2394_ (.A1(_1667_),
    .A2(_2350_),
    .B1(_1901_),
    .Y(_1902_));
 sky130_fd_sc_hd__a22o_1 _2395_ (.A1(_1527_),
    .A2(_0504_),
    .B1(\acc3[24] ),
    .B2(\acc2[24] ),
    .X(_1903_));
 sky130_fd_sc_hd__o21ai_2 _2396_ (.A1(_1527_),
    .A2(_0504_),
    .B1(_1903_),
    .Y(_1904_));
 sky130_fd_sc_hd__a211o_1 _2397_ (.A1(_1670_),
    .A2(_2366_),
    .B1(_1673_),
    .C1(_0499_),
    .X(_1905_));
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
    .A2_N(\diff2_d[18] ),
    .B1(_0962_),
    .B2(\diff2_d[18] ),
    .X(_1074_));
 sky130_fd_sc_hd__or2_1 _3786_ (.A(_1073_),
    .B(_1074_),
    .X(_1075_));
 sky130_fd_sc_hd__inv_2 _3787_ (.A(\diff2_d[17] ),
    .Y(_1076_));
 sky130_fd_sc_hd__inv_2 _3788_ (.A(\diff2_d[16] ),
    .Y(_1077_));
 sky130_fd_sc_hd__a22o_1 _3789_ (.A1(\diff2[17] ),
    .A2(_1076_),
    .B1(\diff2[16] ),
    .B2(_1077_),
    .X(_1078_));
 sky130_fd_sc_hd__o21ai_1 _3790_ (.A1(\diff2[17] ),
    .A2(_1076_),
    .B1(_1078_),
    .Y(_1079_));
 sky130_fd_sc_hd__a211o_1 _3791_ (.A1(_0961_),
    .A2(\diff2_d[19] ),
    .B1(_0962_),
    .C1(\diff2_d[18] ),
    .X(_1080_));
 sky130_fd_sc_hd__o221a_1 _3792_ (.A1(_0961_),
    .A2(\diff2_d[19] ),
    .B1(_1075_),
    .B2(_1079_),
    .C1(_1080_),
    .X(_1081_));
 sky130_fd_sc_hd__or2_1 _3793_ (.A(_1071_),
    .B(_1081_),
    .X(_1082_));
 sky130_fd_sc_hd__o22ai_1 _3794_ (.A1(_0958_),
    .A2(\diff2_d[21] ),
    .B1(_0960_),
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
