ThomasJagielski/MADVLSI-Final_Project/(commit log)

2021-04-13 Add alpha amp schematic
    [alpha_amp.sch, cascode_bias_LDS.sch, diff_amp.sch, folded_cascode_differential_amplifier.sch, folded_cascode_differential_amplifier_LDS.sch]
2021-04-13 add basic, untested CMOS transmission gate
    [switch.sch]
2021-04-13 switch symbol cosmetic
2021-04-13 chop2 schem and symbol
    [chop2.sch]
2021-04-14 parameterize sizing; basic tests
    [chop2.sch, chop2_test.sch, switch.sch, switch_test.sch]
2021-04-15 prelim fgmos diff pair
    [fgmos_diffpair.sch]
2021-04-15 Add new alpha amp
    [alpha_amp.sch, alpha_amp_new.sch, inverter.sch, switched_capacitor_resistor.sch]
2021-04-15 add alpha amp
    [alpha_amp_new.sch]
2021-04-15 update chopper to smaller switches
    [chop2.sch, fgmos_diffpair_test.sch]
2021-04-15 Add alpha amp simulation
    [alpha_amp_new.sch]
2021-04-16 working test of fgmos
    [fgmos_diffpair_test.sch]
2021-04-16 beautify/parameterize symbols; attempted to avoid fast swing
    [alpha_amp_differentialGE.sch, inverter.sch, switch_test.sch]
2021-04-16 Add alpha amp design simulation sample and hold
    [alpha_amp_fancy.sch]
2021-04-17 dummy fpr switch; started clk gen
    [clk_gen.sch, clk_gen_test.sch, nor2.sch, switch.sch]
2021-04-17 working clock gen sim
    [clk_gen.sch, clk_gen_test.sch]
2021-04-17 Add 8-bit shift register
    [shift-register.sch]
2021-04-17 Add 6/8-bit shift registers
    [shift-register-6-bit.sch, shift-register-8-bit.sch]
2021-04-17 Add ping pong amp
    [alpha_amp_ping_pong.sch, shift-register-6-bit.sch, shift-register-8-bit.sch]
2021-04-18 fix shift registers
    [alpha_amp_ping_pong.sch, shift-register-6-bit.sch, shift-register-8-bit.sch]
2021-04-18 Add second version of alpha amp
    [alpha_amp_fancy_new.sch, fully_differential_sc_amp.sch]
2021-04-18 fix chopper
    [chop2.sch]
2021-04-18 Add delta-sigma amplifier
    [sigma_delta_modulator.sch]
2021-04-20 Add sigma-delta modulator
    [sigma_delta_modulator.sch]
2021-04-20 FD FGAMP; data and schem for bandgap
    [Vtemp_test.sch, alpha_amp_FD.sch, bandgap-0C.csv, bandgap-10C.csv, bandgap-11C.csv, bandgap-12C.csv, bandgap-13C.csv, bandgap-14C.csv]
2021-04-20 actually one csv is fine
    [bandgap-0C.csv, bandgap-10C.csv, bandgap-11C.csv, bandgap-12C.csv, bandgap-13C.csv, bandgap-14C.csv, bandgap-15C.csv, bandgap-16C.csv]
2021-04-20 actually changed temperature this time
    [bandgap0-50C.csv]
2021-04-20 working basic bandgap
    [Vtemp_test.sch]
2021-04-21 sweep temp from -10 to 100 with 1.8 vdd
    [bandgap0-50C.csv]
2021-04-21 use multiplicity index,-20 to 100
    [Vtemp_test-20-100C.csv, Vtemp_test.sch, bandgap0-50C.csv, folded_cascode_FD.sch]
2021-04-21 sim data with cmos
    [bandgap-20-100C.csv]
2021-04-21 sim data with cmos and beta cancellation
    [bandgap-20-100C.csv]
2021-04-21 sim data with cmos and beta cancellation; large resistor; right multiplicity
    [bandgap-20-100C.csv]
2021-04-21 try beta cancel again
    [bandgap-20-100C.csv]
2021-04-21 start designing bandgap and bias circuit
    [Vtemp_test.sch, bandgap_test.sch, ibias.sch]
2021-04-22 120k bias resistor like the paper
    [bandgap-20-100C.csv]
2021-04-22 100n bias current
    [bandgap-20-100C.csv]
2021-04-22 hope we fixed the bias
    [bandgap-20-100C.csv]
2021-04-22 50n bias current
    [bandgap-20-100C50nA.csv]
2021-04-22 1u bias current
    [bandgap-20-100C1u.csv]
2021-04-22 functional bandgap test with bbeta cancel
    [bandgap_trantest.sch]
2021-04-22 ndiode temp
    [Vtemp_test-20-100Cndiode.csv]
2021-04-23 Add synthesized decimation filter
2021-04-26 Add fully differential FG diffamp
    [FG_diffamp_full_swing_test.sch, fully_differential_sc_amp.sch]
2021-04-27 Add amplifier
    [FD_diffamp_160.sch, sigma_delta_modulator.sch]
2021-04-27 Add clocking circuit sampl
    [alpha_amp_ping_pong.sch, clocking.sch]
2021-04-27 Add a bad shift register
    [phi1-new.sch, phi1.sch]
2021-04-27 Add clock generator
    [CSRL_D_FF_old.sch, phi1-new.sch, sigma_delta_modulator.sch, sigma_delta_modulator_simple.sch, sigma_delta_modulator_simple_no_chop.sch]
2021-04-28 Add clock
    [phi1-new-circular.sch, phi1-new.sch, sigma_delta_modulator_simple_no_chop.sch]
2021-04-29 specifying the internal state of dff
    [CSRL_D_FF.sch, phi1-new.sch]
2021-04-29 circular phi working
    [phi1.sch]
2021-04-29 Add clock symbols
    [clk_gen.sch]
2021-04-29 the opamp that does not do the op amp thing
    [bandgap_dctemp.sch]
2021-04-29 quantizer initial commit
    [quantizer.sch, sigma_delta_modulator_test.sch]
2021-04-30 Add double-slope schematic
    [double-slope.sch]
2021-04-30 Add integrator
    [fg_integrator.sch, fg_integrator_new.sch, fg_integrator_new_brad.sch]
2021-05-01 does dual slope work?
    [double-slope.sch]
2021-05-01 Add double slope work
    [and2.sch, double-slope-sparsh.sch, mux2.sch]
2021-05-01 Add comparator
    [comparator.sch, double-slope.sch]
2021-05-01 Add double slope
    [comparator.sch, double-slope-thomas.sch]
2021-05-01 Add up down interator simulation
    [fg_integrator.sch]
2021-05-01 Add successive approximation adc
    [double-slope-thomas_new.sch, fg_integrator.sch, successive_approximation_adc.sch]
2021-05-02 Add counter
    [counter_adc.sch, counter_adc_new.sch, counter_new.sch, dff.sch]
2021-05-02 Add ramp adc
    [counter_adc_new.sch, counter_new.sch]
2021-05-02 Add counter_adc
    [counter_adc_new.sch]
2021-05-02 Add circuits
    [counter_adc_new.sch, double-slope-thomas_new.sch, fg_integrator.sch, up_counter.sch]
2021-05-02 add nand gate logic
    [double-slope-thomas_new.sch]
2021-05-03 Add double slope adc
    [double-slope-thomas_new.sch]
2021-05-03 add nmos diff pair
    [nmos_current_mirror_diff_amp.sch]
2021-05-03 SC diff amp
    [bandgap_dctempalt.sch, bandgap_dctempaltamp.sch, bandgap_lv.sch]
2021-05-04 add adc symbol
2021-05-04 Add nmos differential amplifier
    [counter_adc_new.sch, nmos_current_mirror_diff_amp.sch, nmos_integrator_test.sch]
2021-05-04 SC cap circuit
    [SCbandgap-10C.csv, SCbandgap-10C7p56.csv, SCbandgap-10C7p67.csv, SCbandgap-11C.csv, SCbandgap-11C7p56.csv, SCbandgap-11C7p67.csv, SCbandgap-12C.csv, SCbandgap-12C7p56.csv]
2021-05-04 Add working dual-slope
    [double-slope-works.sch]
2021-05-04 Add dual slope circuit
    [double-slope-thomas_new.sch, double-slope-works.sch]
2021-05-04 add reset circuitr
    [double-slope-works.sch]
2021-05-05 working bandgap circuits
    [FG_integrator_test.sch, SCbandgap-10C7p67refVben.csv, SCbandgap-11C7p67refVben.csv, SCbandgap-12C7p67refVben.csv, SCbandgap-13C7p67refVben.csv, SCbandgap-14C7p67refVben.csv, SCbandgap-15C7p67refVben.csv, SCbandgap-16C7p67refVben.csv]
2021-05-05 Add RC value tests
    [double-slope-works.sch]
2021-05-05 add simulation with reset circuit
    [double-slope-works.sch]
2021-05-05 Initialize layout and lds.sch files
    [dff_lds.sch]
2021-05-05 Add reset circuit
    [double-slope-works.sch]
2021-05-05 Add preset clear logic to dff
    [counter_new.sch, counter_new_new.sch, dff.sch, dff_lds.sch]
2021-05-05 Add counter working circuit
    [counter_new.sch, dff.sch]
2021-05-06 Add dual slope adc
    [comparator_amp.sch, counter_reset.sch, double-slope-brad-amp.sch, integrator_test_brad_amp.sch, transmission_gate.sch]
2021-05-06 a magic switch
    [SCbandgap-10C7p67refVben.csv, SCbandgap-11C7p67refVben.csv, SCbandgap-12C7p67refVben.csv, SCbandgap-13C7p67refVben.csv, SCbandgap-14C7p67refVben.csv, SCbandgap-15C7p67refVben.csv, SCbandgap-16C7p67refVben.csv, SCbandgap-17C7p67refVben.csv]
2021-05-06 switch and pnp
2021-05-06 Add working dual slope adc
    [dual_slope_adc.sch]
2021-05-06 Add sample/hold circuit
    [SH.sch, dff_og.sch]
2021-05-06 Add edge triggering for output
    [dual_slope_adc.sch]
2021-05-07 resistor design
2021-05-07 Add lds for self-biased cascode
    [selfbiasedcascode2stage_diff_pair.sch, selfbiasedcascode2stage_lds.sch]
2021-05-07 Add s/h testbench
    [SH_test.sch]
2021-05-08 Add complete cascode lds
    [selfbiasedcascode2stage_lds.sch]
2021-05-08 Add self-biased cascode test harness
    [selfbiasedcascode2stage_lds.sch, selfbiasedcascode2stage_loopgain.sch, selfbiasedcascode2stage_test.sch]
2021-05-08 resistor 160k
2021-05-08 check lds note yet resolved
    [selfbiasedcascode2stage_lds.sch]
2021-05-08 resolve lds issue
    [selfbiasedcascode2stage_lds.sch]
2021-05-08 Fix dff layout rails
2021-05-08 2 stage lds with dummy now
    [selfbiasedcascode2stage_lds.sch]
2021-05-09 up to date bandgap
    [bandgap_dctempaltamptran.sch]
2021-05-09 Add folder restructure
    [CSRL_D_FF.sch, CSRL_D_FF_old.sch, FD_diffamp_160.sch, FG_diffamp_full_swing_test.sch, alpha_amp.sch, alpha_amp_fancy.sch, alpha_amp_fancy_new.sch, alpha_amp_new.sch]
2021-05-09 Add bandgap circuit
    [bandgap_dctempaltamptran.sch]
2021-05-09 self bias with dummies
    [selfbiasedcascode2stage_lds.sch]
2021-05-09 more recent bandgap circuit data
    [SCbandgap-10C.csv, SCbandgap-10C7p56.csv, SCbandgap-10C7p67.csv, SCbandgap-10C7p67refVben.csv, SCbandgap-10C7p75refVben12u.csv, SCbandgap-10C8p00refVben12u.csv, SCbandgap-10C8p25refVben12u.csv, SCbandgap-11C.csv]
2021-05-09 Add lvs for dff
    [and2.sch, inverter.sch]
2021-05-09 Add lvs schematic
    [selfbiasedcascode2stage_lvs.sch]
2021-05-09 start all in one schematic
    [temp_all.sch]
2021-05-09 Add counter layout
    [counter-b0_lvs.sch, counter-bn_lvs.sch]
2021-05-10 Fix cascode lds
    [selfbiasedcascode2stage_lvs.sch]
2021-05-10 ping pong to get close to continuous operations
    [temp_all_pingpong.sch]
2021-05-10 Add layout
    [adc_digital_lvs.sch, comparator_lvs.sch, drive_buffer_lvs.sch, dual_slope_adc.sch, inverter_large.sch, output_register_lvs.sch]
2021-05-10 Add digtial portion of adc layout
2021-05-10 rename capacitor size
2021-05-11 all in one ?
    [temp_all_pingpong.sch]
2021-05-11 Add updates
    [dual_slope_adc_lvs.sch]
2021-05-11 fix np issue
    [temp_all_pingpong.sch]
2021-05-11 switch short diff
2021-05-11 add adc
    [dual_slope_adc_lvs.sch]
2021-05-11 bandgap ext quits magic?
    [bandgap_lvs.sch]
2021-05-11 Add bandgap reference voltage generators
2021-05-11 latest ping pong
    [temp_all_pingpong.sch]
2021-05-11 Add ping pong layout
    [SCbandgap20ptat.csv, bandgap_ping_pong_amp_cell_lvs.sch, temp_all_pingpong.sch]
2021-05-11 Add power routes
2021-05-11 Add bandgap amp
    [bandgap_lvs.sch, bandgap_lvs_simple.sch, bandgap_ping_pong_amp_cell_lvs.sch, bandgap_pnp_lvs.sch, middle_ping_pong_amp.sch, selfbiasedcascode2stage_lds.sch]
2021-05-11 Add bandgap pingpong cell
    [bandgap_ping_pong_amp_cell_lvs.sch]
2021-05-11 Add bandgap pingpong half
    [bandgap_ping_pong_amp_lvs.sch]
2021-05-11 Add bandgap layout
    [bandgap_lvs.sch, bandgap_ping_pong_amp_half_lvs.sch, bandgap_ping_pong_amp_lvs.sch, bandgap_thomas.sch, bandgap_thomas_test.sch, temp_all_pingpong.sch]
2021-05-11 Add temperature sensor full layout
2021-05-12 Add final layout
    [bandgap_ping_pong_amp_lvs.sch, bandgap_ping_pong_amp_thomas_lvs.sch, temp_sense_test_lvs.sch, temperature_sensor_lvs.sch]
